jkimmakes/spice-drawer-organizer/labels/style-preview.png

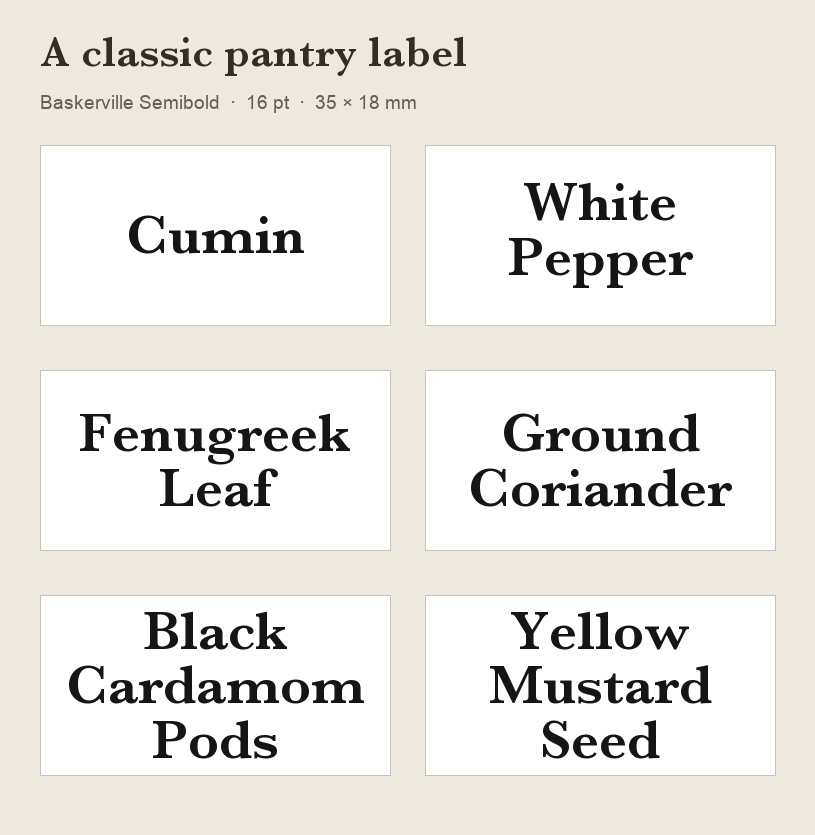
labels/style-preview.png
