jkimmakes/spice-drawer-organizer/accessories/label-jig/ball_4oz_label_jig.stl

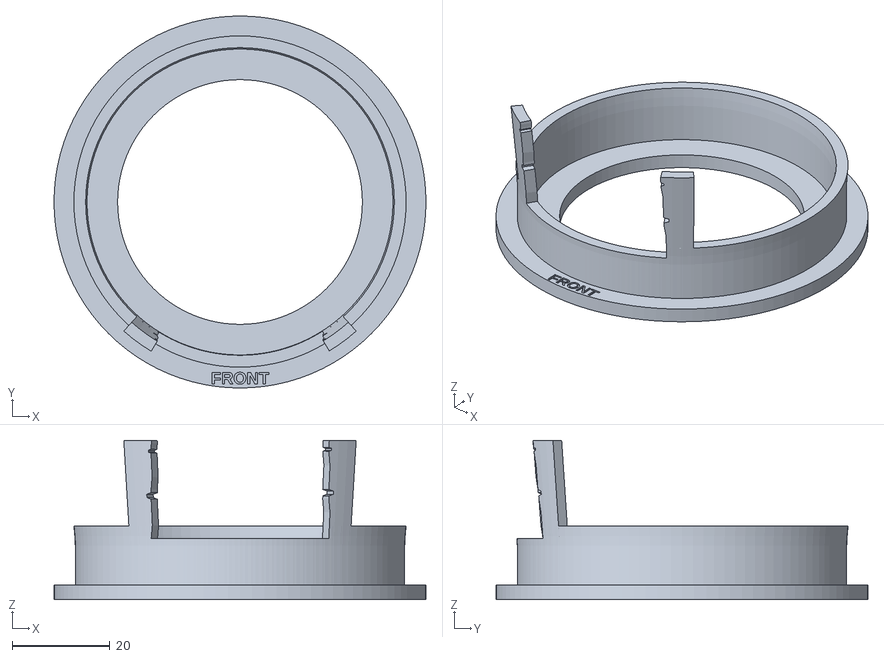
[picture p7: CAD file, 2026-10-19]
accessories/label-jig/ball_4oz_label_jig.stl
76.0 x 76.0 x 32.5
