jkimmakes/spice-drawer-organizer/spice_drawer/data/ball-4oz/key_x.stl

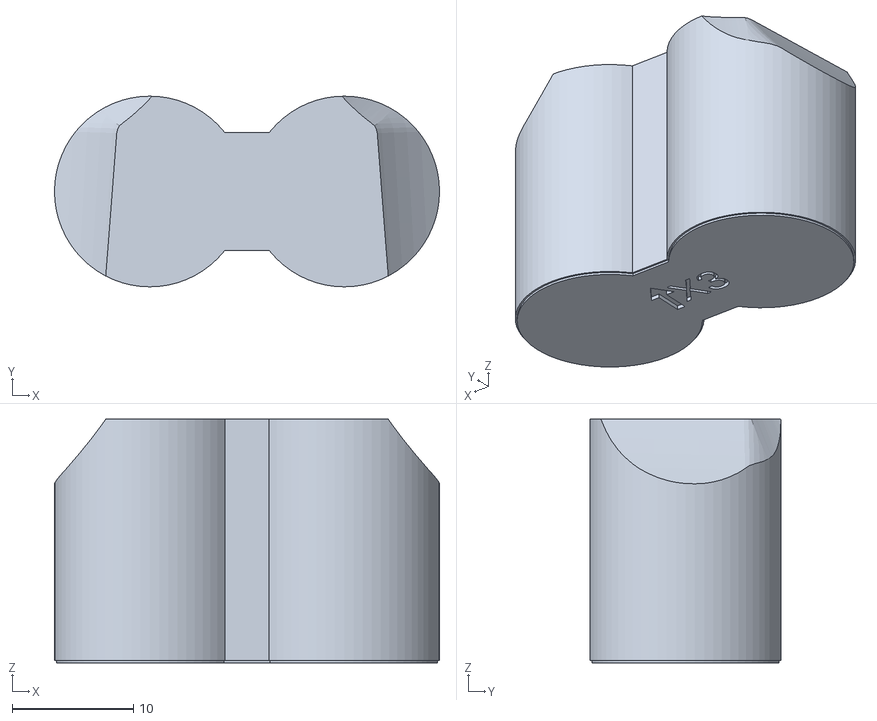
[picture p8: CAD file, 2026-10-17]
spice_drawer/data/ball-4oz/key_x.stl
31.7 x 15.7 x 20.1
