jkimmakes/spice-drawer-organizer/spice_drawer/data/ball-4oz/reference_r2_3x3.stl

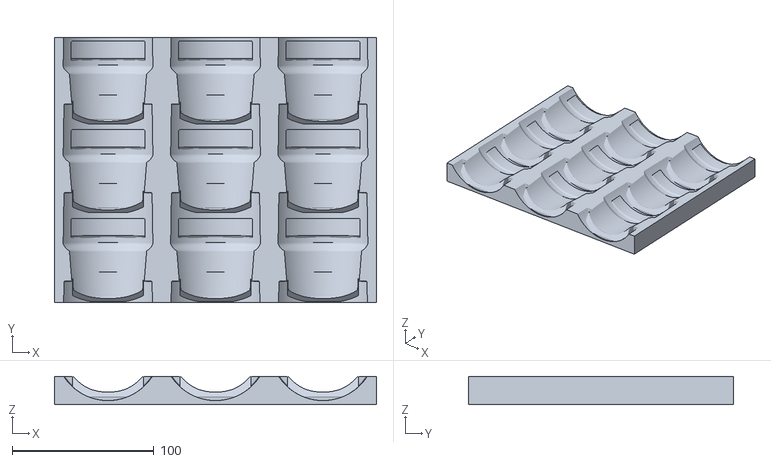
[picture p9: CAD file, 2026-10-17]
spice_drawer/data/ball-4oz/reference_r2_3x3.stl
227.1 x 187.2 x 20.1
