jkimmakes/spice-drawer-organizer/spice_drawer/data/ball-4oz/key_y.stl

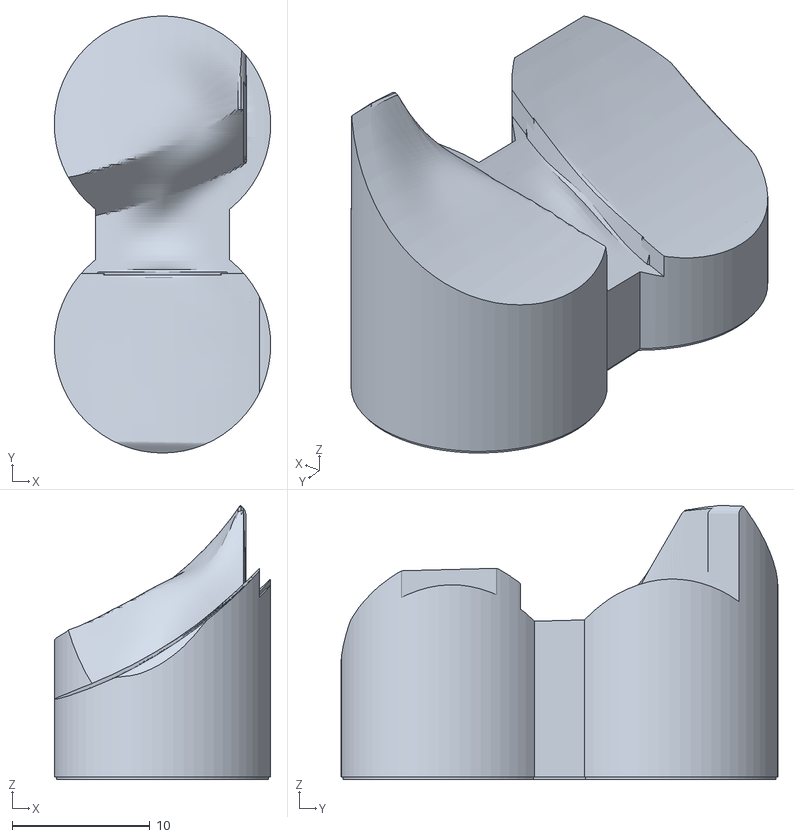
[picture p10: CAD file, 2026-10-17]
spice_drawer/data/ball-4oz/key_y.stl
15.7 x 31.7 x 19.9
