jkimmakes/spice-drawer-organizer/(commit log)

2026-10-17 Add modular spice drawer generator, tested profile and assembly photos
    [check.scad, key_x.stl, key_y.stl, parts.scad, reference_r2_3x3.stl]
2026-10-17 Summarize organizer features and link the Printables release
2026-10-19 Add one-piece label jig and reusable P-touch label printing kit
    [ball_4oz_label_jig.stl, label_jig.scad]
2026-10-21 Save all 40 spice labels and record the additional print jobs
